JonasNorling/geckohat/geckohat.kicad_pcb

## KiCad design geckohat.kicad_pcb (2018-03-13)

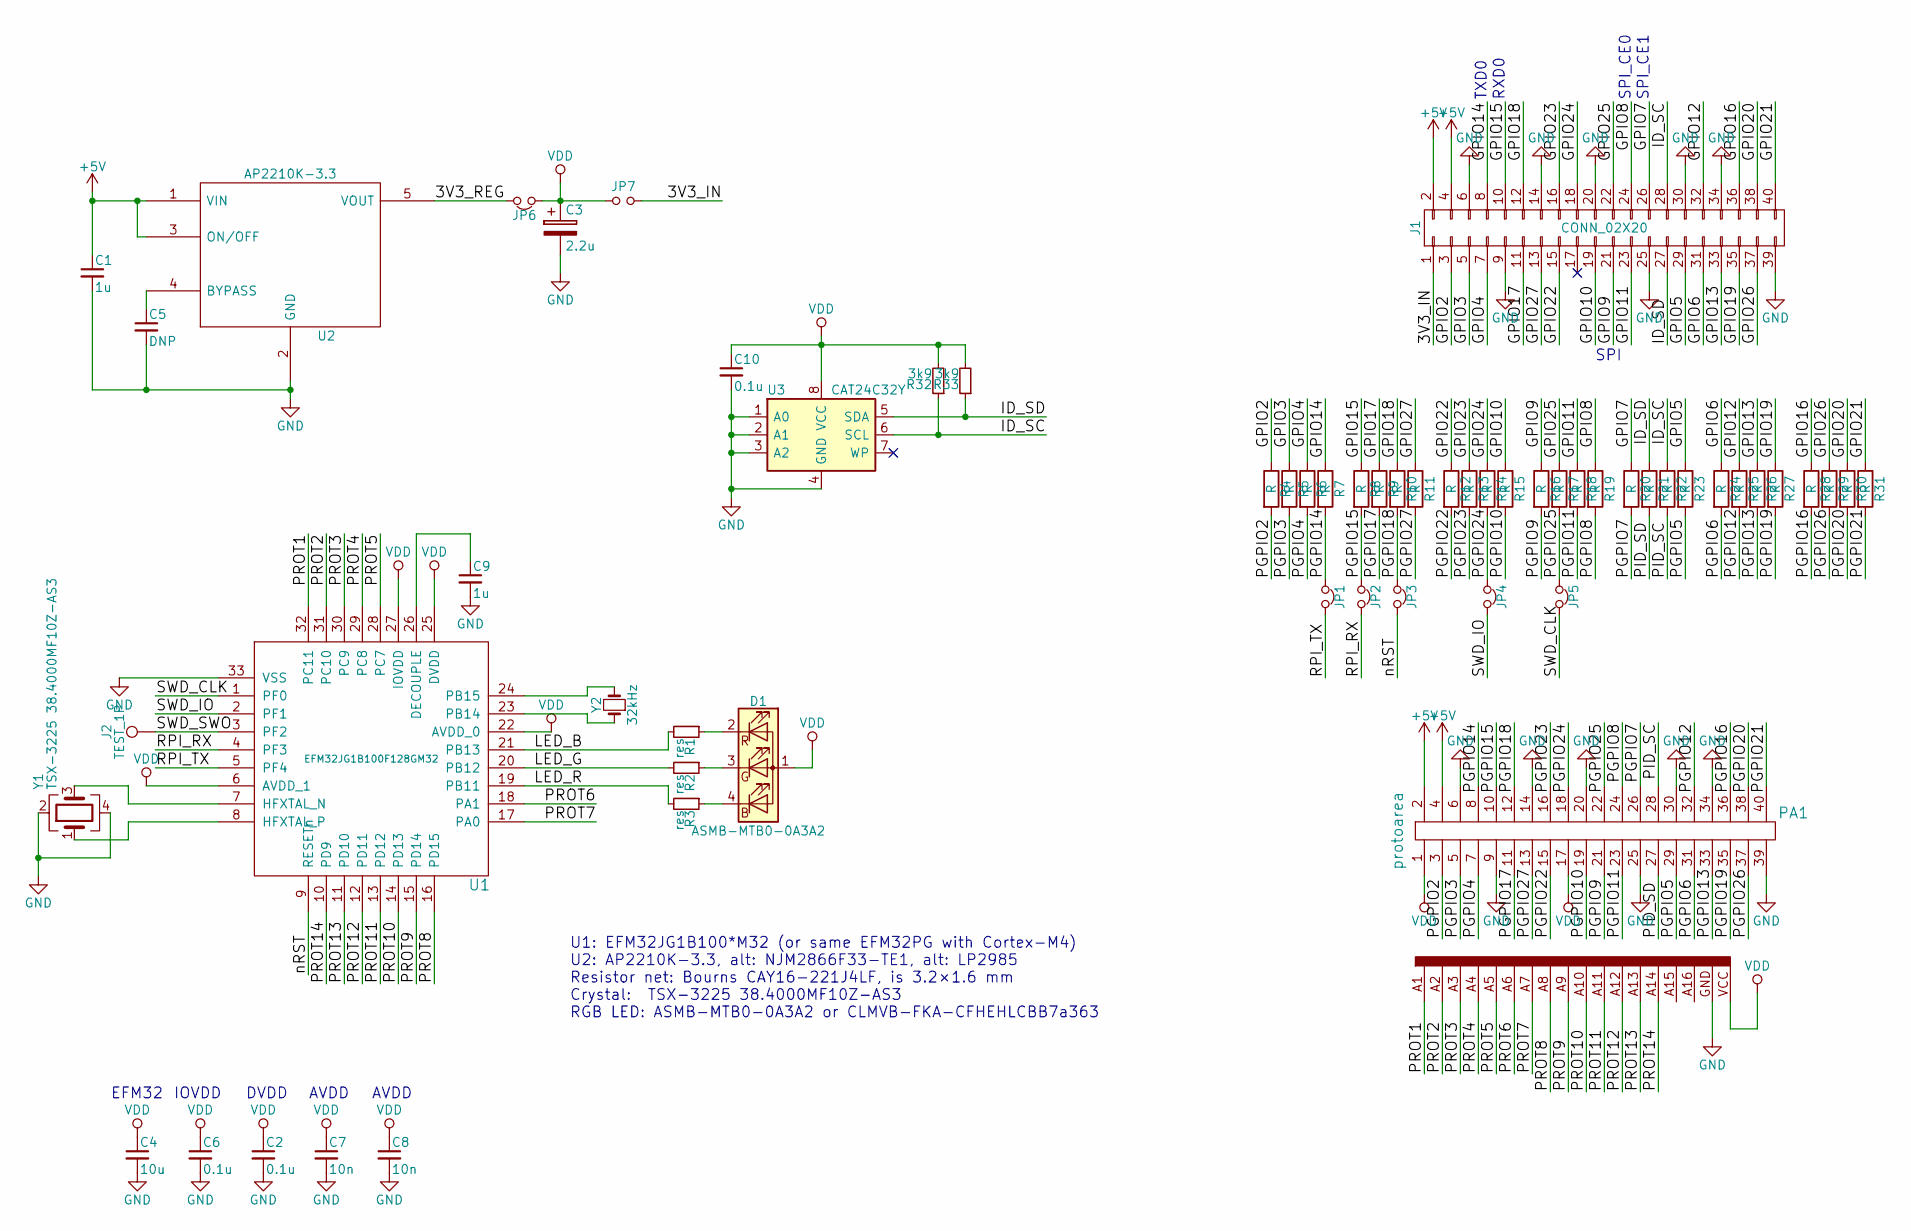
[picture p1: schematic geckohat.sch, Raspberry Pi Gecko hat]

Parts:
C1, C9: 1u; C_0603_1608Metric_Pad0.84x1.00mm_HandSolder
C2, C6, C10: 0.1u; C_0603_1608Metric_Pad0.84x1.00mm_HandSolder
C3: 2.2u; C_0603_1608Metric_Pad0.84x1.00mm_HandSolder
C4: 10u; C_1206_3216Metric_Pad1.24x1.80mm_HandSolder
C5: DNP; C_0603_1608Metric_Pad0.84x1.00mm_HandSolder
C7, C8: 10n; C_0603_1608Metric_Pad0.84x1.00mm_HandSolder
D1: ASMB-MTB0-0A3A2; LED_Avago_PLCC4_3.2x2.8mm_CW
J1: CONN_02X20; Pin_Header_Straight_2x20_Pitch2.54mm
J2: TEST_1P; SolderWirePad_single_1mmDrill
JP1, JP2, JP3, JP4, JP5, JP6: tie; tie_0603
JP7: Jumper_NO_Small; tie_0603_open
PA1: protoarea
R1, R2, R3: res; R_0603_1608Metric_Pad0.84x1.00mm_HandSolder
R4, R5, R6, R7, R8, R9, R10, R11, R12, R13, R14, R15, R16, R17, R18, R19, R20, R21, R22, R23, R24, R25, R26, R27, R28, R29, R30, R31: R; R_0603_1608Metric_Pad0.84x1.00mm_HandSolder
R32, R33: 3k9; R_0603_1608Metric_Pad0.84x1.00mm_HandSolder
U1: EFM32JG1B100F128GM32; QFN-32-handsolder
U2: AP2210K-3.3; SOT-23-5_HandSoldering
U3: CAT24C32Y; TSSOP-8_4.4x3mm_Pitch0.65mm
Y1: TSX-3225 38.4000MF10Z-AS3; Crystal_SMD_SeikoEpson_FA238-4pin_3.2x2.5mm_HandSoldering
Y2: 32kHz; Crystal_C26-LF_d2.1mm_l6.5mm_Vertical

Connections:
+5V: C1.1, J1.2, J1.4, PA1.2, PA1.4, U2.1 (VIN), U2.3 (ON/OFF)
/3V3_IN: J1.1, JP7.2
/3V3_REG: JP6.2, U2.5 (VOUT)
/GPIO2: J1.3, R4.1
/GPIO3: J1.5, R5.1
/GPIO4: J1.7, R6.1
/GPIO5: J1.29, R23.1
/GPIO6: J1.31, R24.1
/GPIO7: J1.26, R20.1
/GPIO8: J1.24, R19.1
/GPIO9: J1.21, R16.1
/GPIO10: J1.19, R15.1
/GPIO11: J1.23, R18.1
/GPIO12: J1.32, R25.1
/GPIO13: J1.33, R26.1
/GPIO14: J1.8, R7.1
/GPIO15: J1.10, R8.1
/GPIO16: J1.36, R28.1
/GPIO17: J1.11, R9.1
/GPIO18: J1.12, R10.1
/GPIO19: J1.35, R27.1
/GPIO20: J1.38, R30.1
/GPIO21: J1.40, R31.1
/GPIO22: J1.15, R12.1
/GPIO23: J1.16, R13.1
/GPIO24: J1.18, R14.1
/GPIO25: J1.22, R17.1
/GPIO26: J1.37, R29.1
/GPIO27: J1.13, R11.1
/ID_SC: J1.28, R22.1, R32.1, U3.6 (SCL)
/ID_SD: J1.27, R21.1, R33.1, U3.5 (SDA)
/LED_B: R1.2, U1.21 (PB13)
/LED_G: R2.2, U1.20 (PB12)
/LED_R: R3.2, U1.19 (PB11)
/PGPIO2: PA1.3, R4.2
/PGPIO3: PA1.5, R5.2
/PGPIO4: PA1.7, R6.2
/PGPIO5: PA1.29, R23.2
/PGPIO6: PA1.31, R24.2
/PGPIO7: PA1.26, R20.2
/PGPIO8: PA1.24, R19.2
/PGPIO9: PA1.21, R16.2
/PGPIO10: PA1.19, R15.2
/PGPIO11: PA1.23, R18.2
/PGPIO12: PA1.32, R25.2
/PGPIO13: PA1.33, R26.2
/PGPIO14: JP1.1, PA1.8, R7.2
/PGPIO15: JP2.1, PA1.10, R8.2
/PGPIO16: PA1.36, R28.2
/PGPIO17: PA1.11, R9.2
/PGPIO18: JP3.1, PA1.12, R10.2
/PGPIO19: PA1.35, R27.2
/PGPIO20: PA1.38, R30.2
/PGPIO21: PA1.40, R31.2
/PGPIO22: PA1.15, R12.2
/PGPIO23: PA1.16, R13.2
/PGPIO24: JP4.1, PA1.18, R14.2
/PGPIO25: JP5.1, PA1.22, R17.2
/PGPIO26: PA1.37, R29.2
/PGPIO27: PA1.13, R11.2
/PID_SC: PA1.28, R22.2
/PID_SD: PA1.27, R21.2
/PROT1: PA1.A1, U1.32 (PC11)
/PROT2: PA1.A2, U1.31 (PC10)
/PROT3: PA1.A3, U1.30 (PC9)
/PROT4: PA1.A4, U1.29 (PC8)
/PROT5: PA1.A5, U1.28 (PC7)
/PROT6: PA1.A6, U1.18 (PA1)
/PROT7: PA1.A7, U1.17 (PA0)
/PROT8: PA1.A8, U1.16 (PD15)
/PROT9: PA1.A9, U1.15 (PD14)
/PROT10: PA1.A10, U1.14 (PD13)
/PROT11: PA1.A11, U1.13 (PD12)
/PROT12: PA1.A12, U1.12 (PD11)
/PROT13: PA1.A13, U1.11 (PD10)
/PROT14: PA1.A14, U1.10 (PD9)
/RPI_RX: JP2.2, U1.4 (PF3)
/RPI_TX: JP1.2, U1.5 (PF4)
/SWD_CLK: JP5.2, U1.1 (PF0)
/SWD_IO: JP4.2, U1.2 (PF1)
/SWD_SWO: J2.1, U1.3 (PF2)
/nRST: JP3.2, U1.9 (RESETn)
GND: C1.2, C2.2, C3.2, C4.2, C5.2, C6.2, C7.2, C8.2, C9.2, C10.2, J1.6, J1.9, J1.14, J1.20, J1.25, J1.30, J1.34, J1.39, PA1.6, PA1.9, PA1.14, PA1.20, PA1.25, PA1.30, PA1.34, PA1.39, PA1.GND, U1.33 (VSS), U2.2 (GND), U3.1 (A0), U3.2 (A1), U3.3 (A2), U3.4 (GND), Y1.2, Y1.4
unnamed: C5.1, U2.4 (BYPASS)
unnamed: C9.1, U1.26 (DECOUPLE)
unnamed: D1.2 (RK), R1.1
unnamed: D1.3 (GK), R2.1
unnamed: D1.4 (BK), R3.1
unnamed: U1.7 (HFXTAL_N), Y1.3
unnamed: U1.8 (HFXTAL_P), Y1.1
unnamed: U1.23 (PB14), Y2.1
unnamed: U1.24 (PB15), Y2.2
VDD: C2.1, C3.1, C4.1, C6.1, C7.1, C8.1, C10.1, D1.1 (A), JP6.1, JP7.1, PA1.1, PA1.17, PA1.VCC, R32.2, R33.2, U1.6 (AVDD_1), U1.22 (AVDD_0), U1.25 (DVDD), U1.27 (IOVDD), U3.8 (VCC)

Notes on the sheet:
U1: EFM32JG1B100*M32 (or same EFM32PG with Cortex-M4) U2: AP2210K-3.3, alt: NJM2866F33-TE1, alt: LP2985 Resistor net: Bourns CAY16-221J4LF, is 3.2×1.6 mm Crystal: TSX-3225 38.4000MF10Z-AS3 RGB LED: ASMB-MTB0-0A3A2 or CLMVB-FKA-CFHEHLCBB7a363
DVDD
IOVDD
EFM32
AVDD
TXD0
RXD0
SPI
SPI_CE0
SPI_CE1

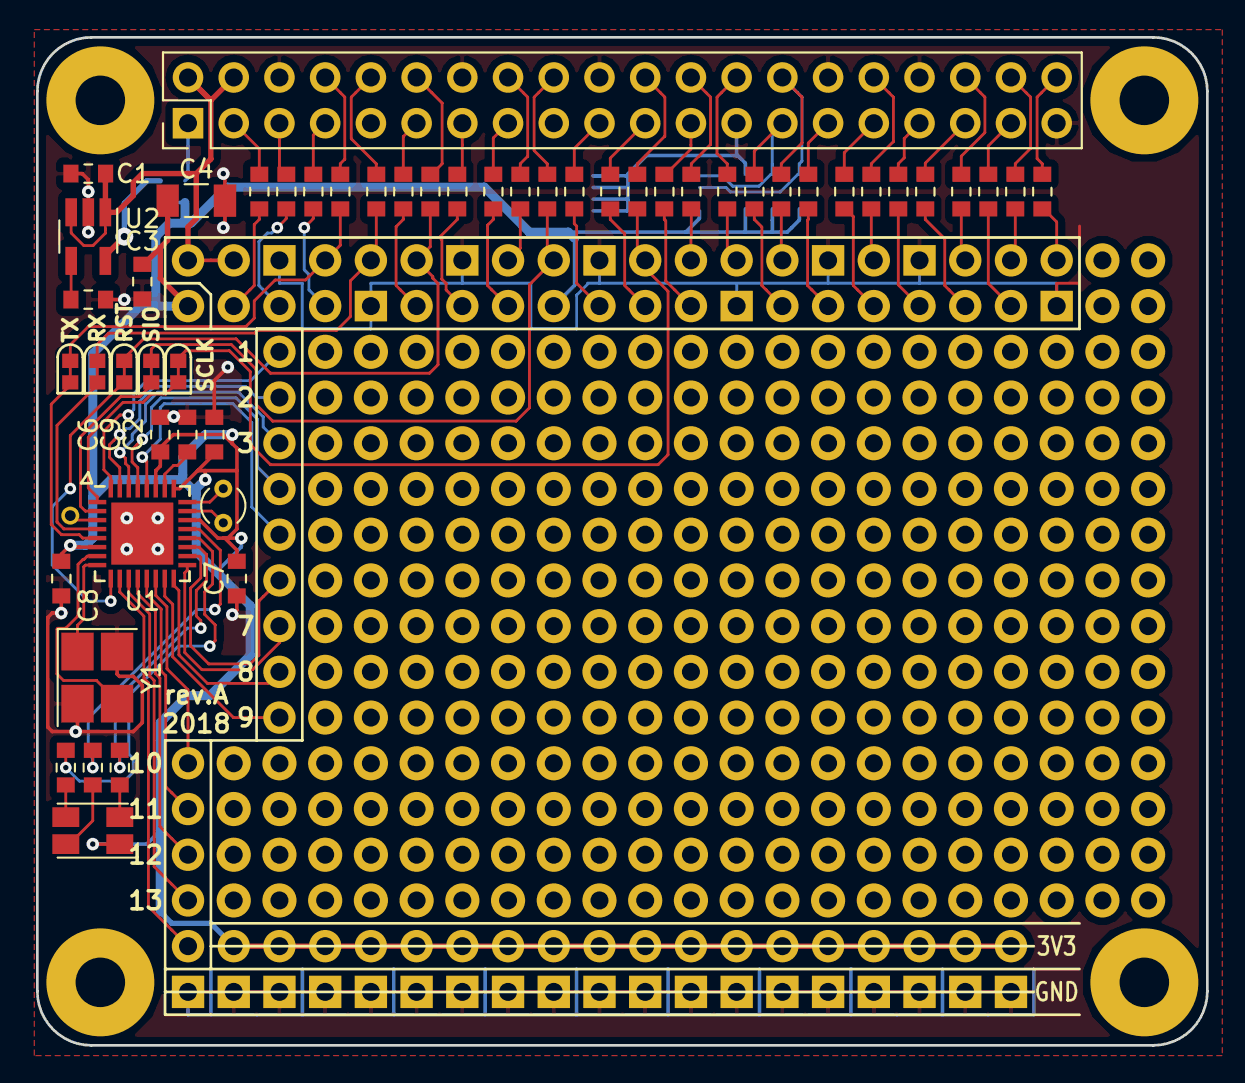
[picture p2: board geckohat.kicad_pcb from above]

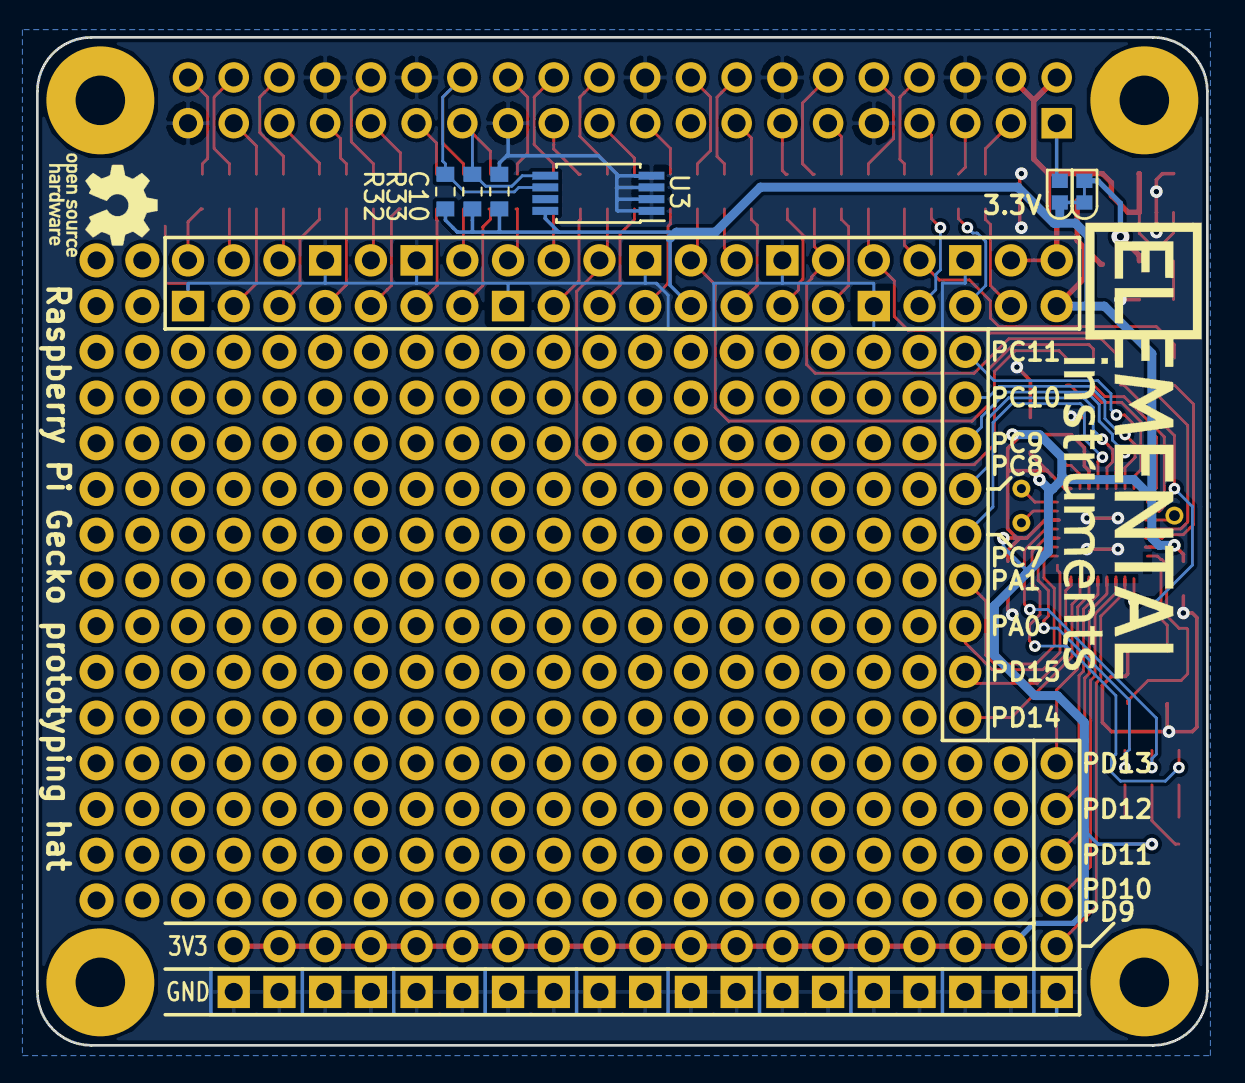
[picture p3: board geckohat.kicad_pcb from below]

Board: 2 copper layers, 65.0 x 56.0 mm, 59 parts (6 on the bottom side), 93 nets.
