JonasNorling/geckohat/(commit log)

2017-08-04 DRC fixes and stuff
    [geckohat.kicad_pcb, geckohat.sch]
2017-08-04 Net ties
    [geckohat.kicad_pcb, geckohat.sch]
2017-08-12 Set metadata, add fixme entries
    [geckohat.kicad_pcb, geckohat.sch]
2017-08-12 Small experimental test board
    [smallboard.kicad_pcb, smallboard.sch]
2017-08-12 Get rid of grounded copper around holes
    [geckohat.kicad_pcb]
2018-02-25 Unknown changes that were lying around
    [geckohat.kicad_pcb, geckohat.sch]
2018-03-10 Work on board: fix header rotation, LED, use discreet resistors
    [geckohat.kicad_pcb, geckohat.sch]
2018-03-10 Replace a couple of cap footprints
    [geckohat.kicad_pcb, geckohat.sch]
2018-03-10 Fix silkscreen
    [geckohat.kicad_pcb]
2018-03-10 Fix 3D pin header
    [geckohat.kicad_pcb]
2018-03-11 Silkscreen updates
    [geckohat.kicad_pcb]
2018-03-11 Specify part numbers
    [geckohat.kicad_pcb, geckohat.sch]
2018-03-11 Fix pinout on proto area
    [geckohat.kicad_pcb]
2018-03-11 Silk work
    [geckohat.kicad_pcb, geckohat.sch]
2018-03-12 More silk work
    [geckohat.kicad_pcb]
2018-03-12 Improve ground fill a bit
    [geckohat.kicad_pcb]
2018-03-13 Change to TSSOP EEPROM, so it fits
    [geckohat.kicad_pcb, geckohat.sch]
2018-03-13 Gerber settings
    [geckohat.kicad_pcb]
2018-03-13 Update to 0.3mm vias, for Seeed Studio
    [geckohat.kicad_pcb]
